isc-fs/IFS08-ES-MainLite/docs/MAIN_LITE_schematic.pdf

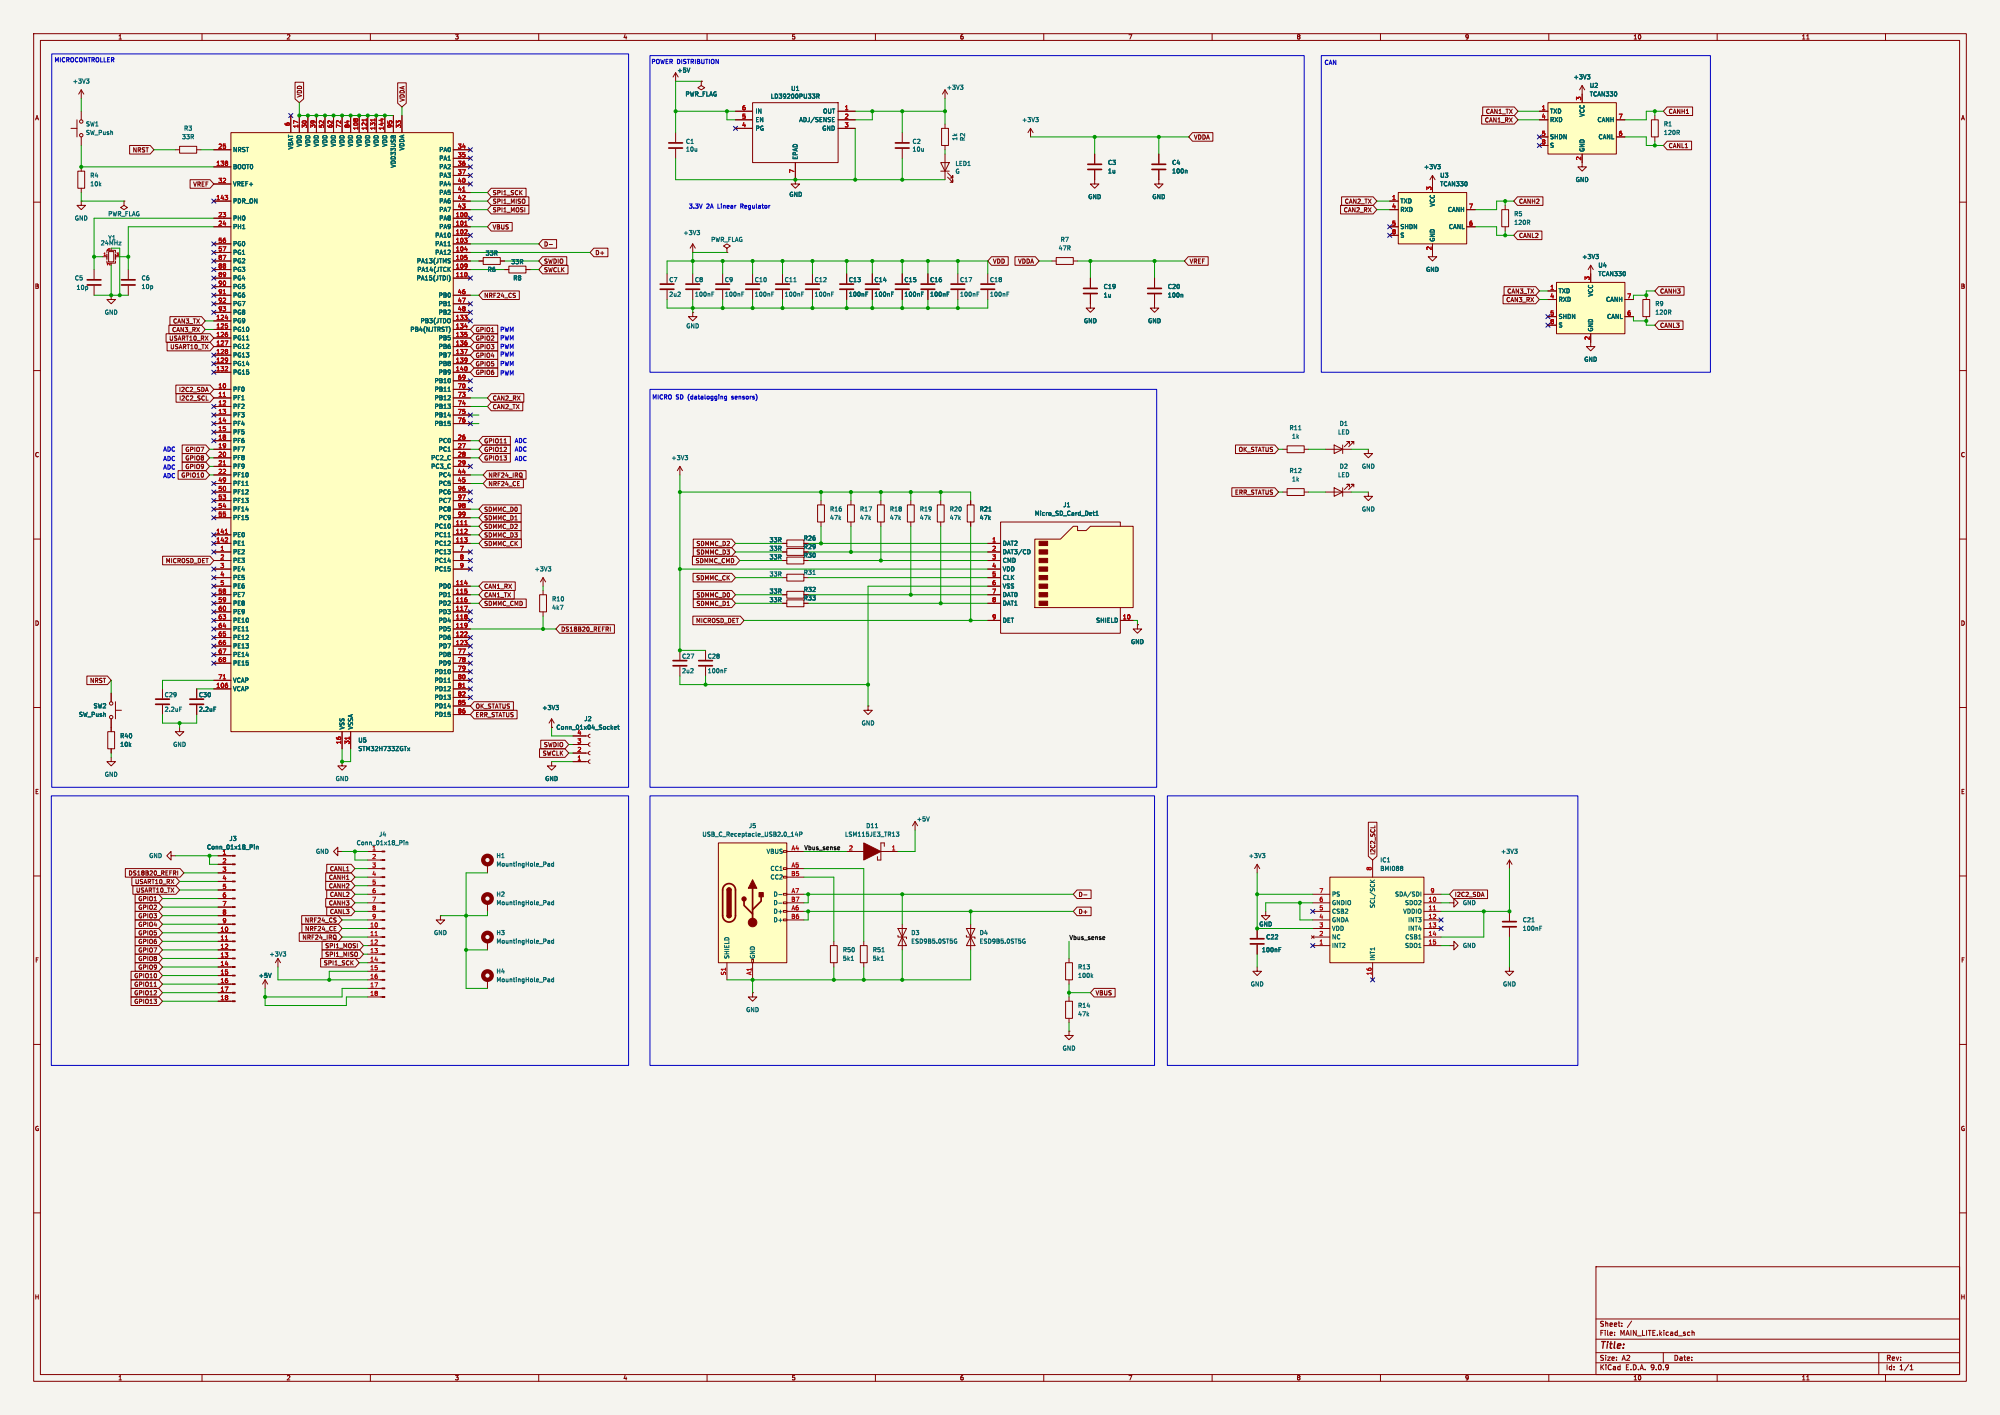
[picture p2: page 1]

6 VDD 17 VDD 30 VDD 39 VDD 52 VDD 62 VDD 72 VSS 16 VDD 84 VSSA 31 VDD 108 VDD 121 VDD 131 VDD 144 VDD33USB 95 VDDA 33 PA0 34 PA1 35 PA2 36 PA3 37 PA4 40 PA5 41 PA6 42 PA7 43 PA8 100 PA9 101 PA10 102 PA11 103 PA12 104 PA13(JTMS 105 PA14(JTCK 109 PA15(JTDI) 110 PB0 46 PB1 47 PB2 48 PB3(JTDO 133 PB4(NJTRST) 134 PB5 135 PB6 136 PB7 137 PB8 139 PB9 140 PB10 69 PB11 70 PB12 73 PB13 74 PB14 75 PB15 76 PC0 26 PC1 27 PC2_C 28 PC3_C 29 PC4 44 PC5 45 PC6 96 PC7 97 PC8 98 PC9 99 PC10 111 PC11 112 PC12 113 PC13 7 PC14 8 PC15 9 PD0 114 PD1 115 PD2 116 PD3 117 PD4 118 PD5 119 PD6 122 PD7 123 PD8 77 PD9 78 PD10 79 PD11 80 PD12 81 PD13 82 PD14 85 PD15 86 U5STM32H733ZGTx

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
