isc-fs/IFS08-ES-MainLite/IFS08-MainLite/MAIN_LITE.kicad_pcb

## KiCad design IFS08-MainLite/MAIN_LITE.kicad_pcb (2026-10-05)

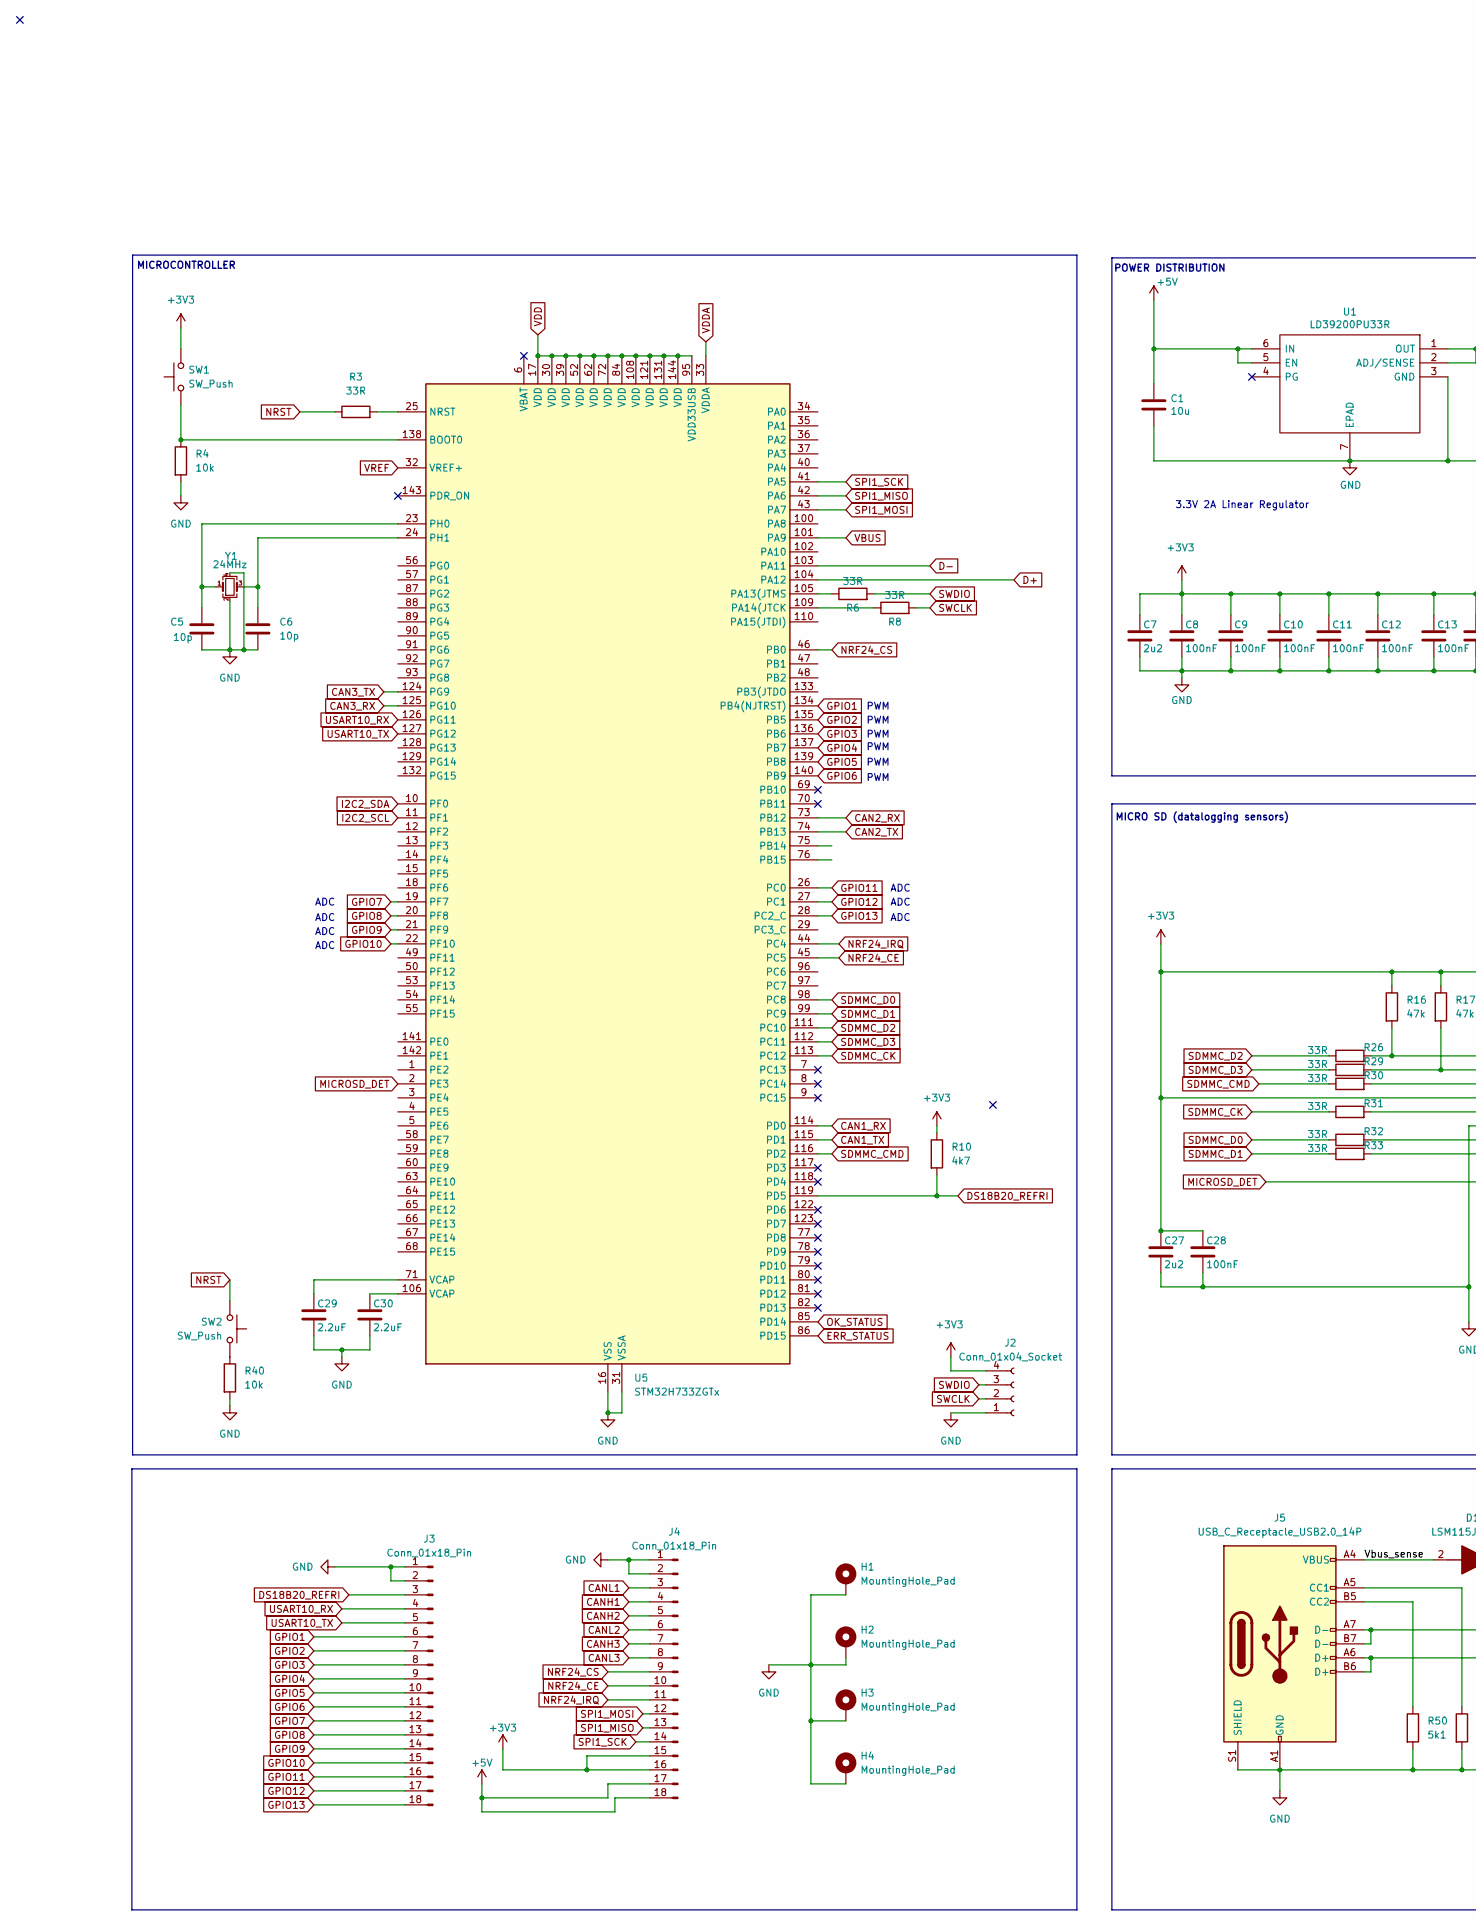
[picture p3: schematic MAIN_LITE.kicad_sch, part in row 1, column 1]

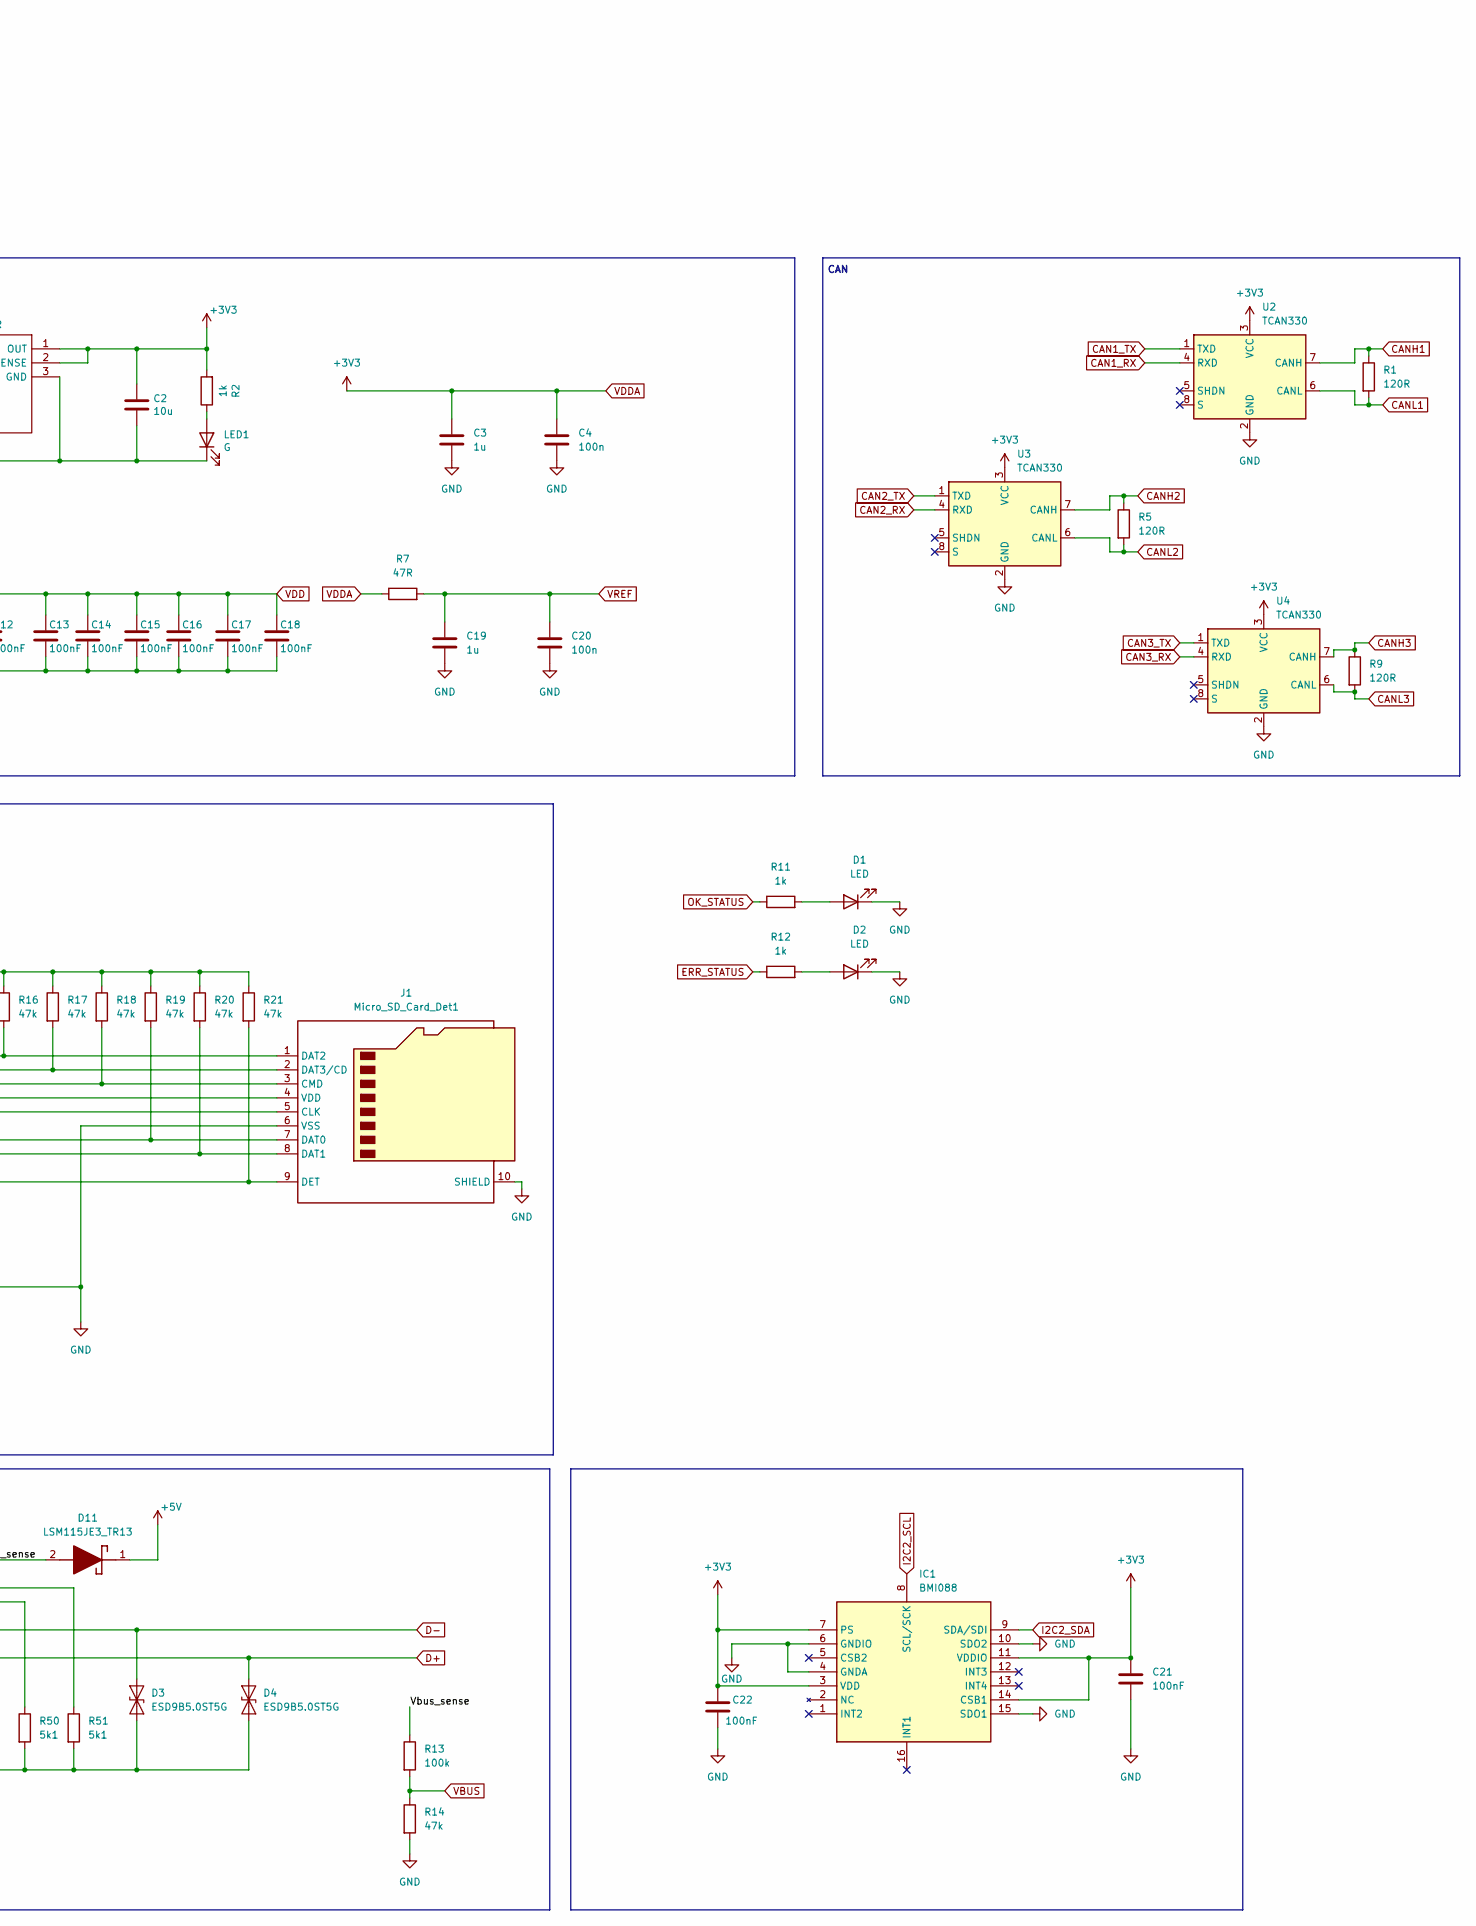
[picture p4: schematic MAIN_LITE.kicad_sch, part in row 1, column 2]

Parts:
C1, C2: 10u; C_0603_1608Metric
C3, C19: 1u; C_0805_2012Metric_Pad1.18x1.45mm_HandSolder
C4, C20: 100n; C_0603_1608Metric_Pad1.08x0.95mm_HandSolder
C5, C6: 10p; C_0603_1608Metric_Pad1.08x0.95mm_HandSolder
C7, C27: 2u2; C_0603_1608Metric_Pad1.08x0.95mm_HandSolder
C8, C9, C10, C11, C12, C13, C14, C15, C16, C17, C18, C28: 100nF; C_0603_1608Metric_Pad1.08x0.95mm_HandSolder
C21, C22: 100nF; C_0402_1005Metric
C29, C30: 2.2uF; C_0805_2012Metric_Pad1.18x1.45mm_HandSolder
D1, D2: LED; LED_0805_2012Metric
D3, D4: ESD9B5.0ST5G; D_SOD-923
D11: LSM115JE3_TR13; DIOM5436X330N; Mouser Part Number 494-LSM115JE3/TR13
H1, H2, H3, H4: MountingHole_Pad; MountingHole_3.2mm_M3_DIN965_Pad
IC1: BMI088; Mouser Part Number 262-BMI088
J1: Micro_SD_Card_Det1; microSD_HC_Molex_104031-0811
J2: Conn_01x04_Socket; PinHeader_1x04_P2.54mm_Vertical
J3, J4: Conn_01x18_Pin; PinHeader_1x18_P2.54mm_Vertical
J5: USB_C_Receptacle_USB2.0_14P; USB_C_Receptacle_GCT_USB4085
LED1: G; LED_0805_2012Metric
R1, R5, R9: 120R; R_0805_2012Metric_Pad1.20x1.40mm_HandSolder
R2: 1k; R_0603_1608Metric
R3, R6, R8, R26, R29, R30, R31, R32, R33: 33R; R_0805_2012Metric_Pad1.20x1.40mm_HandSolder
R4, R40: 10k; R_0805_2012Metric_Pad1.20x1.40mm_HandSolder
R7: 47R; R_0805_2012Metric_Pad1.20x1.40mm_HandSolder
R10: 4k7; R_0603_1608Metric_Pad0.98x0.95mm_HandSolder
R11, R12: 1k; R_0603_1608Metric_Pad0.98x0.95mm_HandSolder
R13: 100k; R_0603_1608Metric_Pad0.98x0.95mm_HandSolder
R14, R16, R17, R18, R19, R20, R21: 47k; R_0603_1608Metric_Pad0.98x0.95mm_HandSolder
R50, R51: 5k1; R_0603_1608Metric_Pad0.98x0.95mm_HandSolder
SW1, SW2: SW_Push; SW_SPST_B3U-1000P-B
U1: LD39200PU33R; SON95P300X300X100-7N-D; Manufacturer_Part_Number LD39200PU33R; Mouser Part Number 511-LD39200PU33R
U2, U3, U4: TCAN330; SOIC-8_3.9x4.9mm_P1.27mm
U5: STM32H733ZGTx; LQFP-144_20x20mm_P0.5mm
Y1: 24MHz; Crystal_SMD_2520-4Pin_2.5x2.0mm

Connections:
+5V: C1.1, D11.1 (K), J4.17, J4.18, U1.5 (EN), U1.6 (IN)
/Vbus_sense: D11.2 (A), J5.A4 (VBUS), J5.A9 (VBUS), J5.B4 (VBUS), J5.B9 (VBUS), R13.1
CAN1_RX: U2.4 (RXD), U5.114 (PD0)
CAN1_TX: U2.1 (TXD), U5.115 (PD1)
CAN2_RX: U3.4 (RXD), U5.73 (PB12)
CAN2_TX: U3.1 (TXD), U5.74 (PB13)
CAN3_RX: U4.4 (RXD), U5.125 (PG10)
CAN3_TX: U4.1 (TXD), U5.124 (PG9)
CANH1: J4.4, R1.1, U2.7 (CANH)
CANH2: J4.5, R5.1, U3.7 (CANH)
CANH3: J4.7, R9.1, U4.7 (CANH)
CANL1: J4.3, R1.2, U2.6 (CANL)
CANL2: J4.6, R5.2, U3.6 (CANL)
CANL3: J4.8, R9.2, U4.6 (CANL)
D+: D4.2 (A2), J5.A6 (D+), J5.B6 (D+), U5.104 (PA12)
D-: D3.2 (A2), J5.A7 (D-), J5.B7 (D-), U5.103 (PA11)
DS18B20_REFRI: J3.3, R10.2, U5.119 (PD5)
ERR_STATUS: R12.1, U5.86 (PD15)
GND: C1.2, C2.2, C3.1, C4.1, C5.2, C6.2, C7.2, C8.2, C9.2, C10.2, C11.2, C12.2, C13.2, C14.2, C15.2, C16.2, C17.2, C18.2, C19.1, C20.1, C21.2, C22.2, C27.2, C28.2, C29.2, C30.2, D1.1 (K), D2.1 (K), D3.1 (A1), D4.1 (A1), H1.1, H2.1, H3.1, H4.1, IC1.4 (GNDA), IC1.6 (GNDIO), IC1.10 (SDO2), IC1.15 (SDO1), J1.6 (VSS), J1.10 (SHIELD), J2.1, J3.1, J3.2, J4.1, J4.2, J5.A1 (GND), J5.A12 (GND), J5.B1 (GND), J5.B12 (GND), J5.S1 (SHIELD), LED1.1 (K), R4.2, R14.2, R40.2, R50.2, R51.2, U1.3 (GND), U1.7 (EPAD), U2.2 (GND), U3.2 (GND), U4.2 (GND), U5.16 (VSS), U5.31 (VSSA), U5.38 (VSS), U5.51 (VSS), U5.61 (VSS), U5.83 (VSS), U5.94 (VSS), U5.107 (VSS), U5.120 (VSS), U5.130 (VSS), Y1.2, Y1.4
GPIO1: J3.6, U5.134 (PB4(NJTRST))
GPIO2: J3.7, U5.135 (PB5)
GPIO3: J3.8, U5.136 (PB6)
GPIO4: J3.9, U5.137 (PB7)
GPIO5: J3.10, U5.139 (PB8)
GPIO6: J3.11, U5.140 (PB9)
GPIO7: J3.12, U5.19 (PF7)
GPIO8: J3.13, U5.20 (PF8)
GPIO9: J3.14, U5.21 (PF9)
GPIO10: J3.15, U5.22 (PF10)
GPIO11: J3.16, U5.26 (PC0)
GPIO12: J3.17, U5.27 (PC1)
GPIO13: J3.18, U5.28 (PC2_C)
I2C2_SCL: IC1.8 (SCL/SCK), U5.11 (PF1)
I2C2_SDA: IC1.9 (SDA/SDI), U5.10 (PF0)
MICROSD_DET: J1.9 (DET), R21.2, U5.2 (PE3)
NRF24_CE: J4.10, U5.45 (PC5)
NRF24_CS: J4.9, U5.46 (PB0)
NRF24_IRQ: J4.11, U5.44 (PC4)
NRST: R3.1, SW2.2
unnamed: C29.1, U5.71 (VCAP)
unnamed: C30.1, U5.106 (VCAP)
unnamed: D1.2 (A), R11.2
unnamed: D2.2 (A), R12.2
unnamed: J1.5 (CLK), R31.2
unnamed: J1.3 (CMD), R18.2, R30.2
unnamed: J1.7 (DAT0), R19.2, R32.2
unnamed: J1.8 (DAT1), R20.2, R33.2
unnamed: J1.1 (DAT2), R16.2, R26.2
unnamed: J1.2 (DAT3/CD), R17.2, R29.2
unnamed: J5.A5 (CC1), R51.1
unnamed: J5.B5 (CC2), R50.1
unnamed: LED1.2 (A), R2.1
unnamed: R40.1, SW2.1
unnamed: R4.1, SW1.1, U5.138 (BOOT0)
unnamed: R3.2, U5.25 (NRST)
unnamed: R6.1, U5.105 (PA13(JTMS)
unnamed: R8.1, U5.109 (PA14(JTCK)
unnamed: C5.1, U5.23 (PH0), Y1.1
unnamed: C6.1, U5.24 (PH1), Y1.3
OK_STATUS: R11.1, U5.85 (PD14)
SDMMC_CK: R31.1, U5.113 (PC12)
SDMMC_CMD: R30.1, U5.116 (PD2)
SDMMC_D0: R32.1, U5.98 (PC8)
SDMMC_D1: R33.1, U5.99 (PC9)
SDMMC_D2: R26.1, U5.111 (PC10)
SDMMC_D3: R29.1, U5.112 (PC11)
SPI1_MISO: J4.13, U5.42 (PA6)
SPI1_MOSI: J4.12, U5.43 (PA7)
SPI1_SCK: J4.14, U5.41 (PA5)
SWCLK: J2.2, R8.2
SWDIO: J2.3, R6.2
USART10_RX: J3.4, U5.126 (PG11)
USART10_TX: J3.5, U5.127 (PG12)
VBUS: R13.2, R14.1, U5.101 (PA9)
VDD: C2.1, C3.2, C4.2, C7.1, C8.1, C9.1, C10.1, C11.1, C12.1, C13.1, C14.1, C15.1, C16.1, C17.1, C18.1, C21.1, C22.1, C27.1, C28.1, IC1.3 (VDD), IC1.7 (PS), IC1.11 (VDDIO), IC1.14 (CSB1), J1.4 (VDD), J2.4, J4.15, J4.16, R2.2, R7.1, R10.1, R16.1, R17.1, R18.1, R19.1, R20.1, R21.1, SW1.2, U1.1 (OUT), U1.2 (ADJ/SENSE), U2.3 (VCC), U3.3 (VCC), U4.3 (VCC), U5.17 (VDD), U5.30 (VDD), U5.33 (VDDA), U5.39 (VDD), U5.52 (VDD), U5.62 (VDD), U5.72 (VDD), U5.84 (VDD), U5.95 (VDD33USB), U5.108 (VDD), U5.121 (VDD), U5.131 (VDD), U5.144 (VDD)
VREF: C19.2, C20.2, R7.2, U5.32 (VREF+)

Notes on the sheet:
ADC
PWM
MICRO SD (datalogging sensors)
3.3V 2A Linear Regulator
CAN
MICROCONTROLLER
POWER DISTRIBUTION

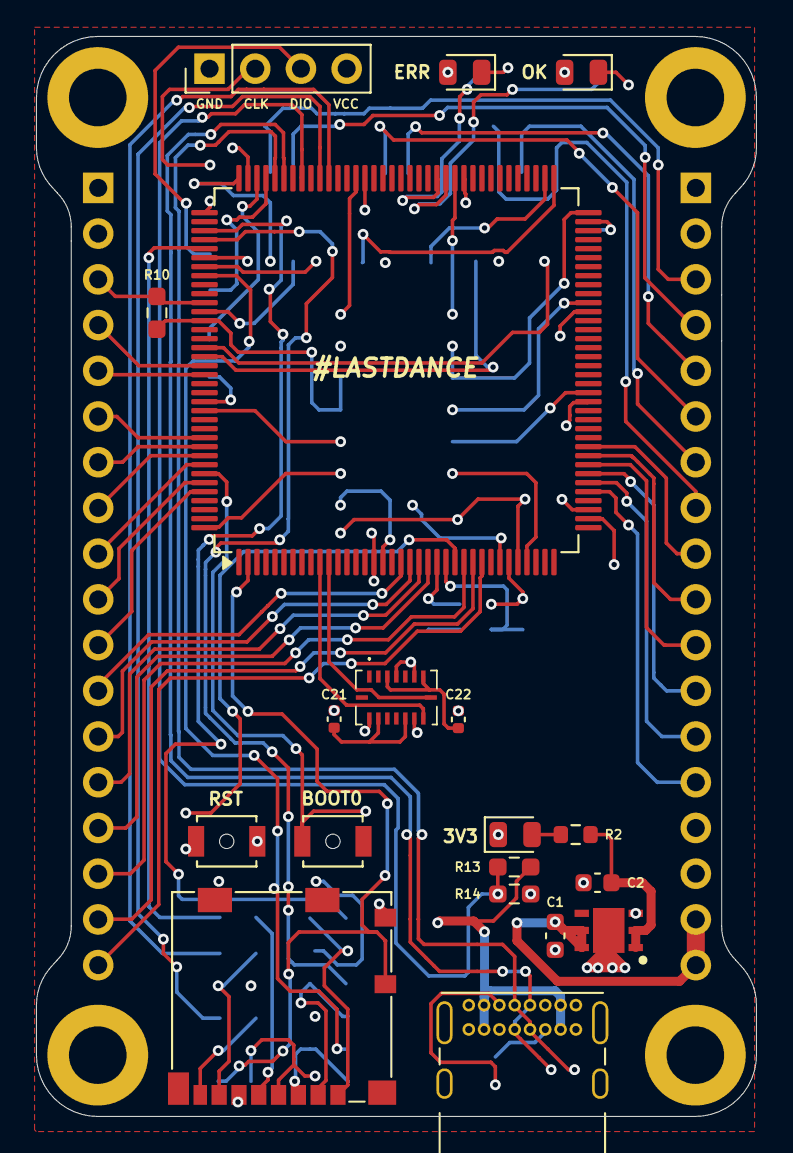
[picture p5: board MAIN_LITE.kicad_pcb from above]

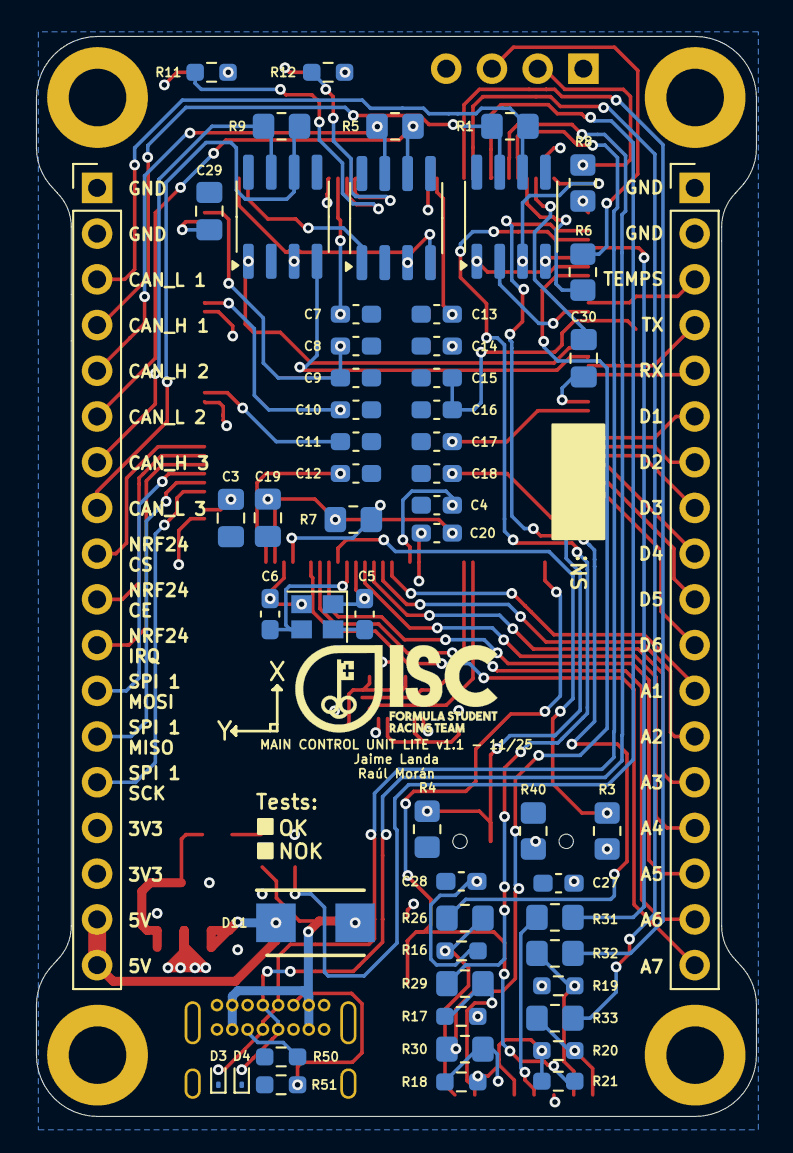
[picture p6: board MAIN_LITE.kicad_pcb from below]

Board: 2 copper layers, 40.0 x 60.0 mm, 80 parts (57 on the bottom side), 76 nets.

Other parts of the board:
G3: LOGO; LogoISC
