isc-fs/IFS08-ES-MainLite/(commit log)

2026-10-05 feat(docs): initialize IFS08-ES-MainLite repository
    Import the MainLite KiCad 9 design (schematic, PCB, local libraries,
    fabrication outputs v1.1) from the 2025-2026 PCB_MAIN_LITE project,
    with README, schematic PDF, interactive BOM and KiCad .gitignore.
    Left out: KiCad backups/.history, fp-info-cache, .kicad_prl, the 25 MB
    board STEP export and local libraries the design does not use.
    [MAIN_LITE.kicad_pcb, MAIN_LITE.kicad_sch, bom.csv, designators.csv, positions.csv]
2026-10-05 feat(ci): generate machine-readable pin model and check it in CI
    tools/gen_pins.py exports the schematic netlist with kicad-cli and writes
    model/mainlite.pins.yaml (+ JSON twin): all 144 STM32H733ZG pins with net,
    alternate function (from vendored ST open pin data), J3/J4 routing,
    on-board connections, pulls and series resistors, plus the CAN, SDMMC,
    I2C, HSE, VBAT, SWD and USB interfaces and the power rails.
    CI (pinned kicad/kicad:9.0.9) fails a PR whose committed model is stale,
    runs model tests and uploads the KiCad ERC report (non-blocking for now).
    Pushes to main publish the model as a pin-model-vN.M release when it
    changes. Format and consumer guide in docs/pin-model.md.
    [erc_summary.py, gen_pins.py]
2026-10-06 fix(hw): make schematic ERC-clean and fail CI on ERC errors
    - Add no-connect flags to the 53 unwired STM32 pins that ERC reported
    (pin_not_connected).
    - Add PWR_FLAGs on GND, +3V3/VDD and +5V (power_pin_not_driven: the
    LD39200 output and the backplane +5V have no power-output pin type).
    - Remove two dangling no-connect flags (one placed off-sheet).
    - Set ERC_BLOCKING to true; re-export the schematic PDF.
    Connectivity is unchanged: the netlist is identical; the pin model only
    changes in no_connect_flag and schematic_git_blob.
    [MAIN_LITE.kicad_sch]
2026-10-06 feat(docs): add MainLite work order WO-IFS08-MLITE-001
    Work order in the SmartFuses format (ISC base template styles): Word
    source, PDF export and synchronized Markdown in docs/. Covers purpose,
    architecture, component and interface requirements (J3/J4 pinout, CAN
    allocation, on-board peripherals, module roles), pin-model directive,
    open items for the next revision, verification protocol, QA sign-off
    sheet and design report requirements.
